FBN-Lidar-Support/Height_Tilt_Measurement/Properties/insert_img.jpg

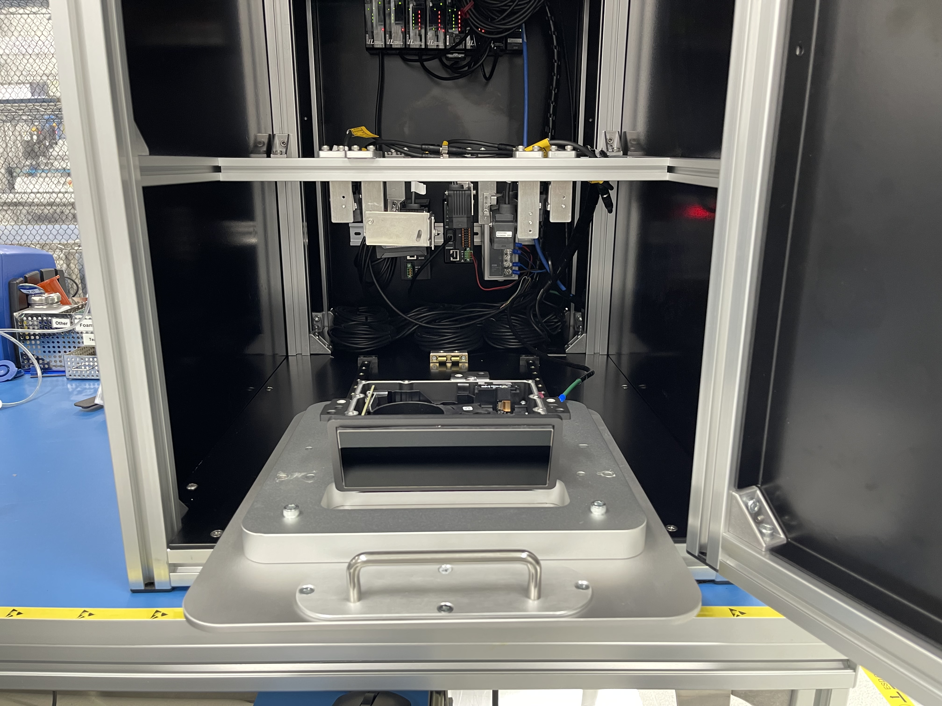
Properties/insert_img.jpg
