FBN-Lidar-Support/Height_Tilt_Measurement/Properties/LR_OB.jpg

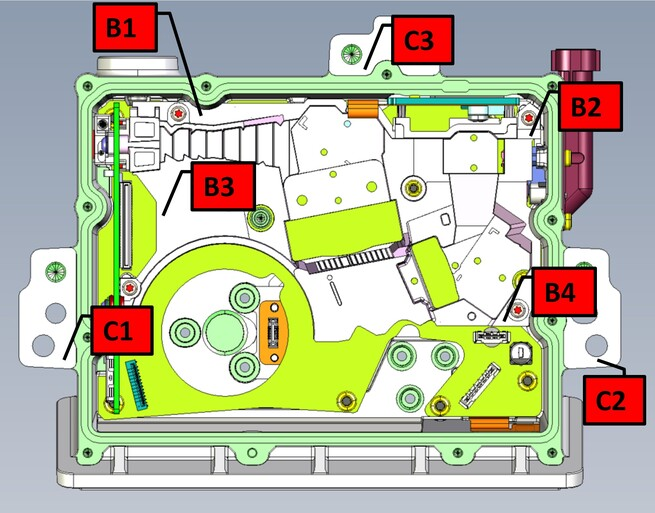
Properties/LR_OB.jpg
