FBN-Lidar-Support/Height_Tilt_Measurement/Properties/SR_OB.jpg

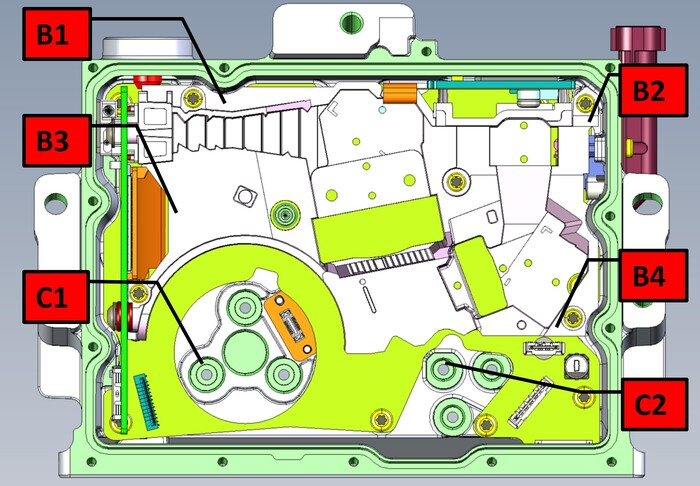
Properties/SR_OB.jpg
