FBN-Lidar-Support/Height_Tilt_Measurement/Doc/ASY00573/ASY00573.STEP

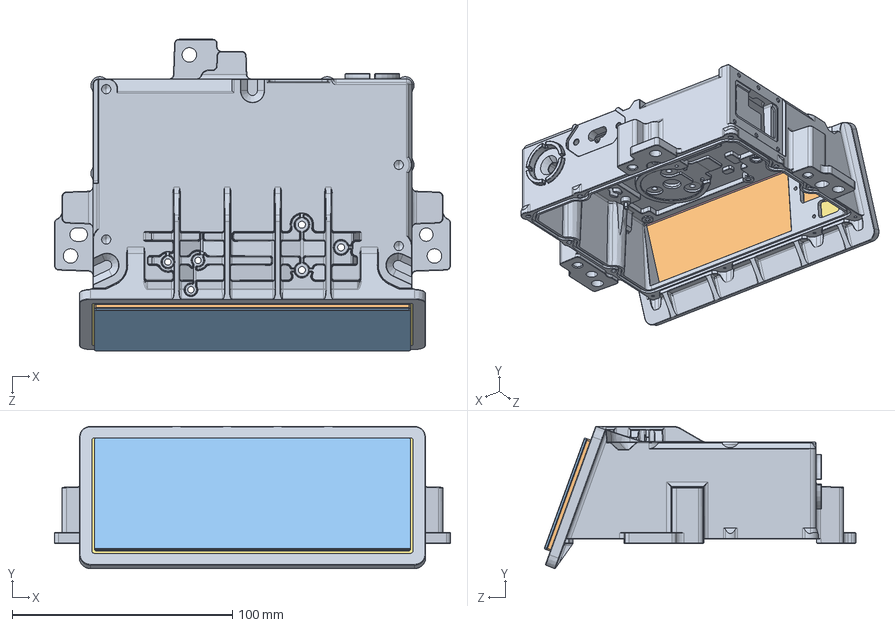
[picture p4: CAD file, 2025-10-30]
Doc/ASY00573/ASY00573.STEP
180.0 x 64.7 x 141.6 mm
MEP02395
Internal Glass Layer^OPT00293_B2.1, Extended Front Window, Saphire & ITO, 20 Deg
External Sapphire Layer^OPT00293_B2.1, Extended Front Window, Saphire & ITO, 20 Deg
PVB^OPT00293_B2.1, Extended Front Window, Saphire & ITO, 20 Deg
Bussbar^OPT00293_B2.1, Extended Front Window, Saphire & ITO, 20 Deg
ITO^OPT00293_B2.1, Extended Front Window, Saphire & ITO, 20 Deg
FPC^PCB00312_B2.1_Win_Heater_Flex
Stiffiner FR4 0.01In^PCB00312_B2.1_Win_Heater_Flex
PSA 3M 9082 2mil^PCB00312_B2.1_Win_Heater_Flex
Stiffener PSA^PCB00312_B2.1_Win_Heater_Flex
Thremistor 0402
Part1^ASY00594
ADH00018^ASY00573
ADH00006^ASY00573
