FBN-Lidar-Support/Height_Tilt_Measurement/Doc/ASY00573/MEP02395.pdf

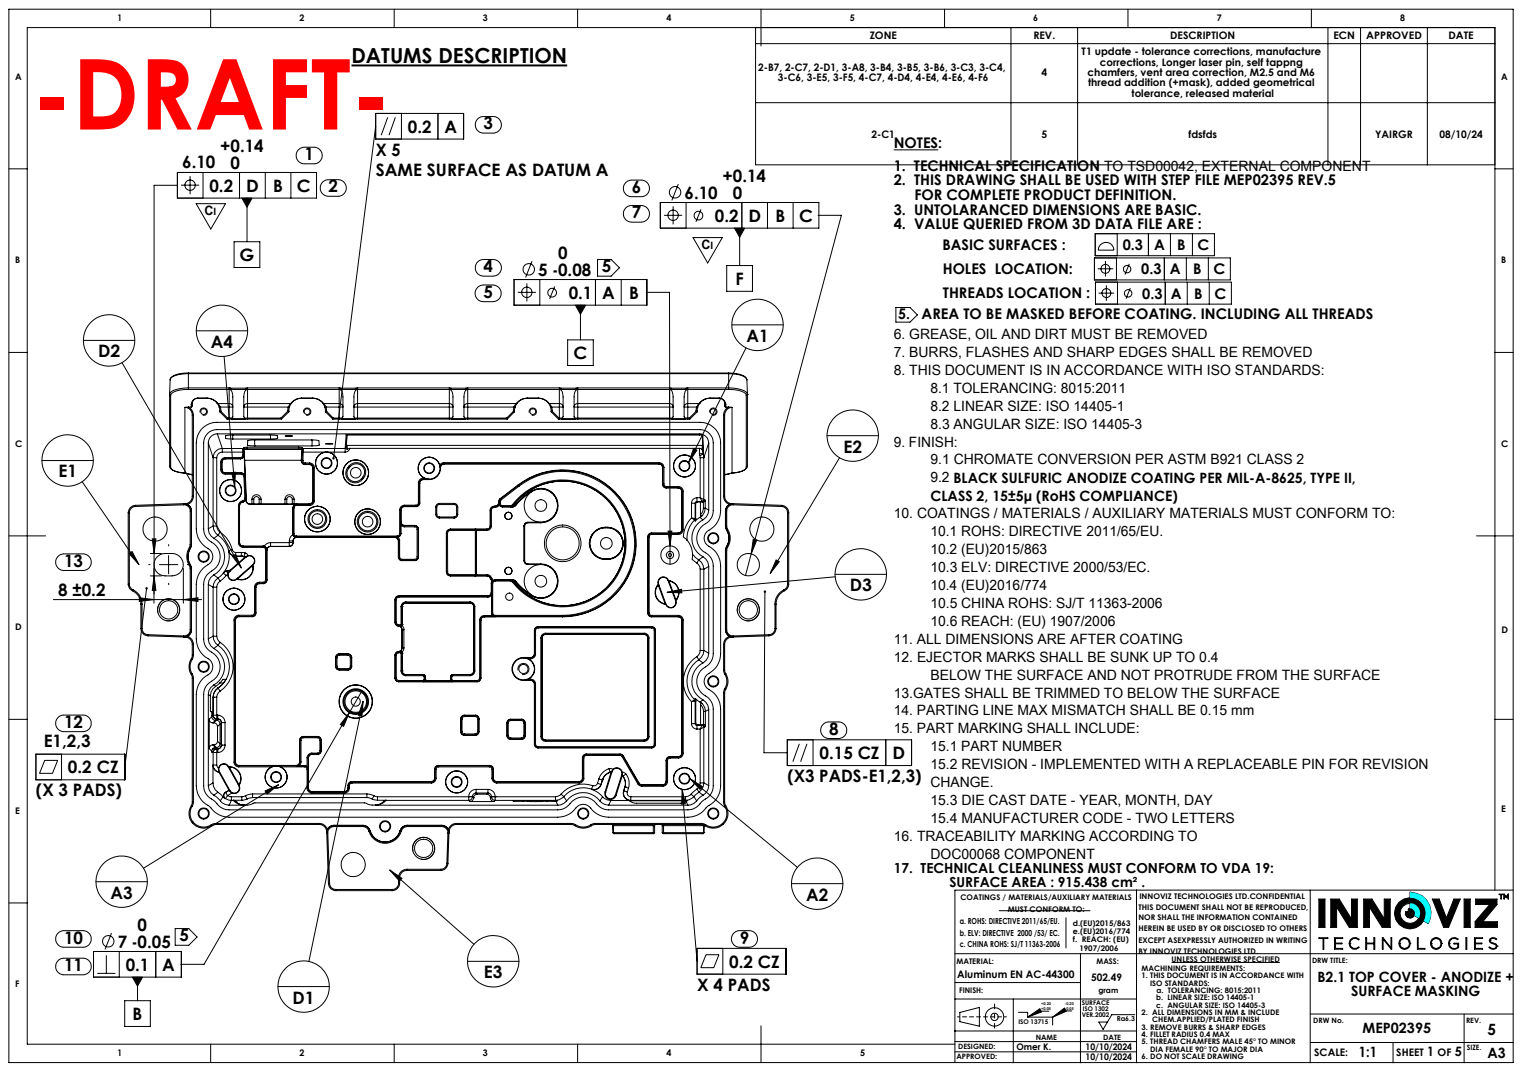
[picture p5: page 1]
ISO 13715; X 5 SAME SURFACE AS DATUM A; 0.2 CZ (X 3 PADS); 0.2 CZ X 4 PADS; DATUMS DESCRIPTION; DRW No.; BASIC SURFACES :; HOLES LOCATION:; THREADS LOCATION :

ZONE | REV. | DESCRIPTION | ECN | APPROVED | DATE

2-B7, 2-C7, 2-D1, 3-A8, 3-B4, 3-B5, 3-B6, 3-C3, 3-C4, 3-C6, 3-E5, 3-F5, 4-C7, 4-D4, 4-E4, 4-E6, 4-F6 | 4 | T1 update - tolerance corrections, manufacture corrections, Longer laser pin, self tappng chamfers, vent area correction, M2.5 and M6 thread addition (+mask), added geometrical tolerance, released material

2-C1 NOTES: | 5 | fdsfds | | YAIRGR | 08/10/24

1. TECHNICAL SPECIFICATION TO TSD00042, EXTERNAL COMPONENT
2. THIS DRAWING SHALL BE USED WITH STEP FILE MEP02395 REV.5
FOR COMPLETE PRODUCT DEFINITION.
3. UNTOLARANCED DIMENSIONS ARE BASIC.
4. VALUE QUERIED FROM 3D DATA FILE ARE :
5. AREA TO BE MASKED BEFORE COATING. INCLUDING ALL THREADS
6. GREASE, OIL AND DIRT MUST BE REMOVED
7. BURRS, FLASHES AND SHARP EDGES SHALL BE REMOVED
8. THIS DOCUMENT IS IN ACCORDANCE WITH ISO STANDARDS:
8.1 TOLERANCING: 8015:2011
8.2 LINEAR SIZE: ISO 14405-1
8.3 ANGULAR SIZE: ISO 14405-3
9. FINISH:

9.1 CHROMATE CONVERSION PER ASTM B921 CLASS 2
9.2 BLACK SULFURIC ANODIZE COATING PER MIL-A-8625, TYPE II,
CLASS 2, 15±5μ (RoHS COMPLIANCE)
10. COATINGS / MATERIALS / AUXILIARY MATERIALS MUST CONFORM TO:
10.1 ROHS: DIRECTIVE 2011/65/EU.
10.3 ELV: DIRECTIVE 2000/53/EC.
10.5 CHINA ROHS: SJ/T 11363-2006
10.6 REACH: (EU) 1907/2006
11. ALL DIMENSIONS ARE AFTER COATING
12. EJECTOR MARKS SHALL BE SUNK UP TO 0.4
BELOW THE SURFACE AND NOT PROTRUDE FROM THE SURFACE
13.GATES SHALL BE TRIMMED TO BELOW THE SURFACE
14. PARTING LINE MAX MISMATCH SHALL BE 0.15 mm
(X3 PADS-E1,2,3)

15. PART MARKING SHALL INCLUDE:
15.1 PART NUMBER
15.2 REVISION - IMPLEMENTED WITH A REPLACEABLE PIN FOR REVISION
CHANGE.
15.3 DIE CAST DATE - YEAR, MONTH, DAY
15.4 MANUFACTURER CODE - TWO LETTERS
16. TRACEABILITY MARKING ACCORDING TO
DOC00068 COMPONENT
17. TECHNICAL CLEANLINESS MUST CONFORM TO VDA 19:
SURFACE AREA : 915.438 cm² .

COATINGS / MATERIALS/AUXILIARY MATERIALS MUST CONFORM TO: a. ROHS: DIRECTIVE 2011/65/EU. d.(EU)2015/863 e.(EU)2016/774 b. ELV: DIRECTIVE 2000 /53/ EC. f. REACH: (EU) c. CHINA ROHS: SJ/T 11363-2006 1907/2006 | INNOVIZ TECHNOLOGIES LTD.CONFIDENTIAL THIS DOCUMENT SHALL NOT BE REPRODUCED, NOR SHALL THE INFORMATION CONTAINED HEREIN BE USED BY OR DISCLOSED TO OTHERS EXCEPT ASEXPRESSLY AUTHORIZED IN WRITING BY INNOVIZ TECHNOLOGIES LTD.

MATERIAL: Aluminum EN AC-44300 FINISH: | MASS: 502.49 gram | UNLESS OTHERWISE SPECIFIED MACHINING REQUIREMENTS: 1. THIS DOCUMENT IS IN ACCORDANCE WITH ISO STANDARDS: a. TOLERANCING: 8015:2011 b. LINEAR SIZE: ISO 14405-1 c. ANGULAR SIZE: ISO 14405-3 2. ALL DIMENSIONS IN MM & INCLUDE CHEM.APPLIED/PLATED FINISH 3. REMOVE BURRS & SHARP EDGES 4. FILLET RADIUS 0.4 MAX 5. THREAD CHAMFERS MALE 45° TO MINOR DIA FEMALE 90° TO MAJOR DIA 6. DO NOT SCALE DRAWING | DRW TITLE: B2.1 TOP COVER - ANODIZE + SURFACE MASKING

+0.20 -0.20 +0.05 -0.05 | SURFACE ISO 1302 VER.2002 Ra6.3

APPROVED: DESIGNED: | | NAME Omer K. | DATE 10/10/2024 10/10/2024
SCALE: 1:1 | SHEET 1 OF 5 | SIZE. A3

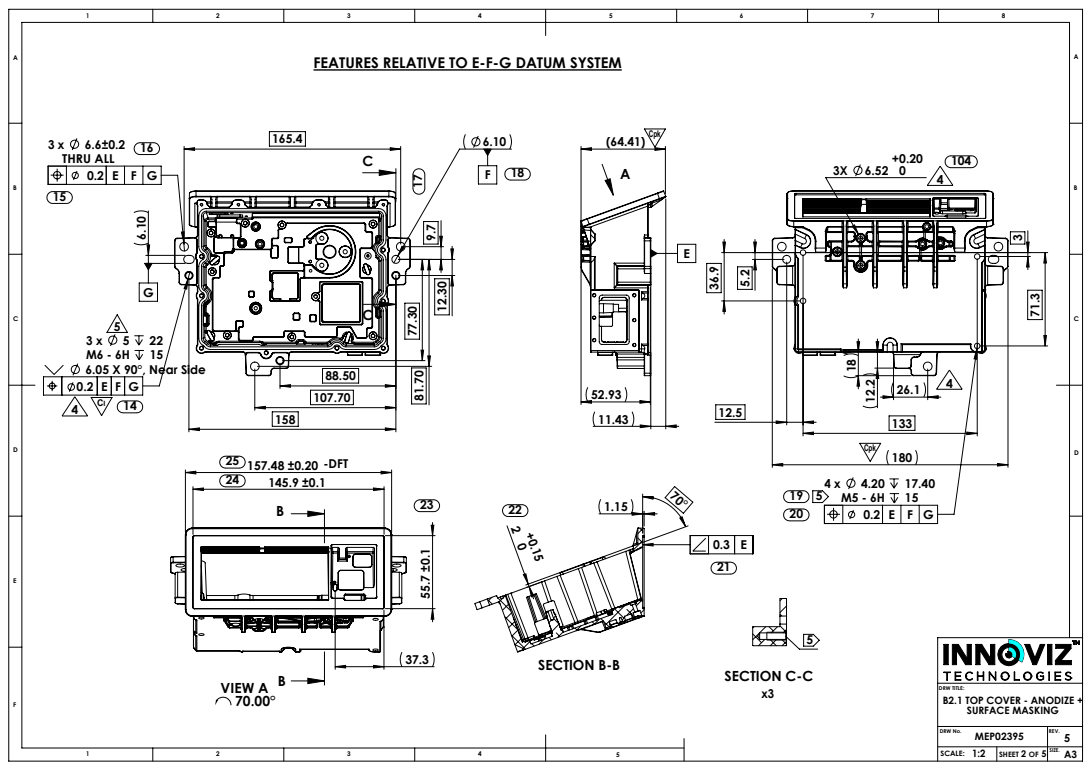
[picture p6: page 2]
3 x 6.6±0.2 THRU ALL; 3 x 5 22 M6 - 6H 15 6.05 X 90°, Near Side; 157.48 ±0.20 -DFT; B VIEW A; SECTION B-B; SECTION C-C

FEATURES RELATIVE TO E-F-G DATUM SYSTEM

DRW TITLE:
B2.1 TOP COVER - ANODIZE +
SURFACE MASKING

MEP02395 | 5
SCALE: 1:2 | SHEET 2 OF 5 | A3

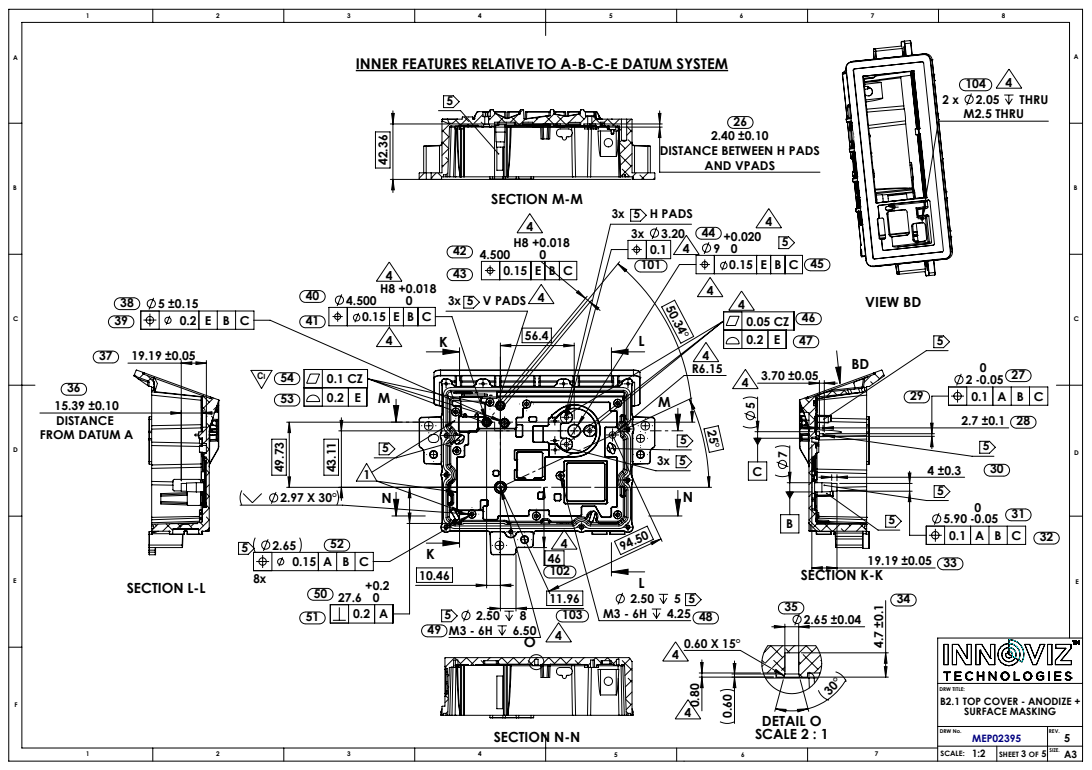
[picture p7: page 3]
3x 5 V PADS; 3x 5 H PADS; SECTION K-K; FROM DATUM A; SECTION L-L; SECTION N-N; DETAIL O SCALE 2 : 1; 2.40 ±0.10 DISTANCE BETWEEN H PADS AND VPADS; SECTION M-M; 5 2 x 2.05 THRU M2.5 THRU; VIEW BD; SCALE:; SHEET 3 OF 5

INNER FEATURES RELATIVE TO A-B-C-E DATUM SYSTEM

DRW TITLE:
B2.1 TOP COVER - ANODIZE +
SURFACE MASKING

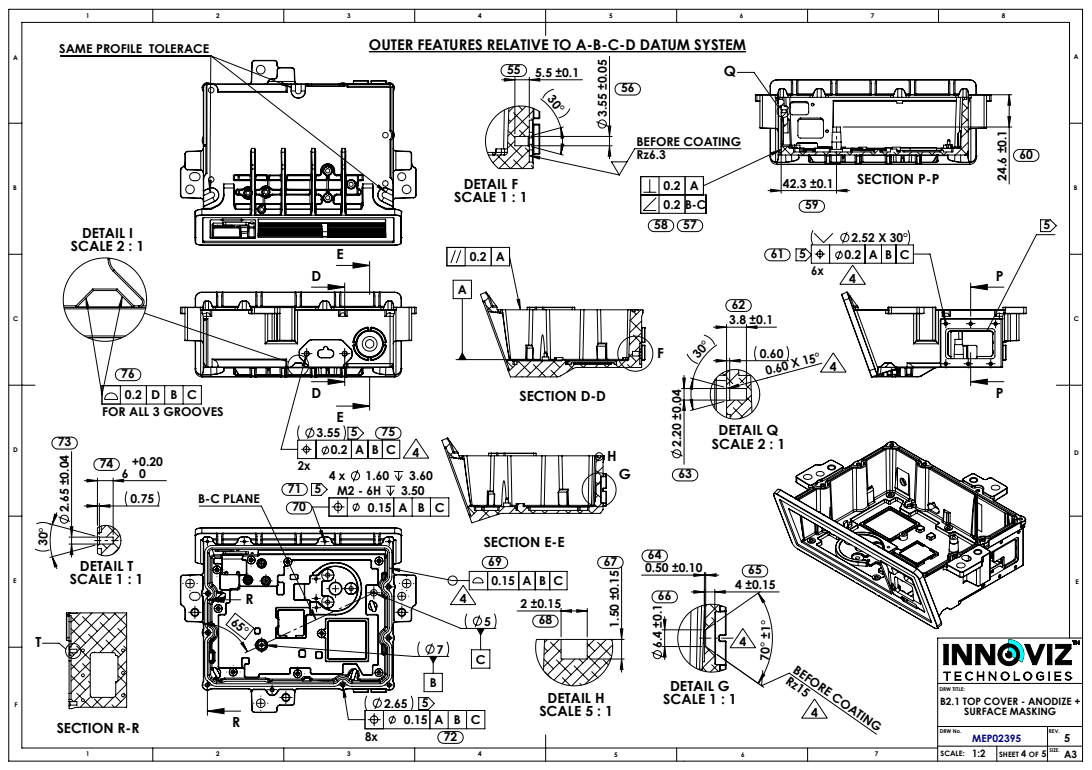
[picture p8: page 4]
B-C PLANE; SECTION D-D; SECTION E-E; DETAIL F SCALE 1 : 1; BEFORE COATING; DETAIL G SCALE 1 : 1; DETAIL H SCALE 5 : 1; DETAIL I SCALE 2 : 1; 0.2 D B C FOR ALL 3 GROOVES; SECTION P-P; DETAIL Q SCALE 2 : 1; SECTION R-R; DETAIL T SCALE 1 : 1; SCALE:; SHEET 4 OF 5

OUTER FEATURES RELATIVE TO A-B-C-D DATUM SYSTEM

SAME PROFILE TOLERACE

DRW TITLE:
B2.1 TOP COVER - ANODIZE +
SURFACE MASKING

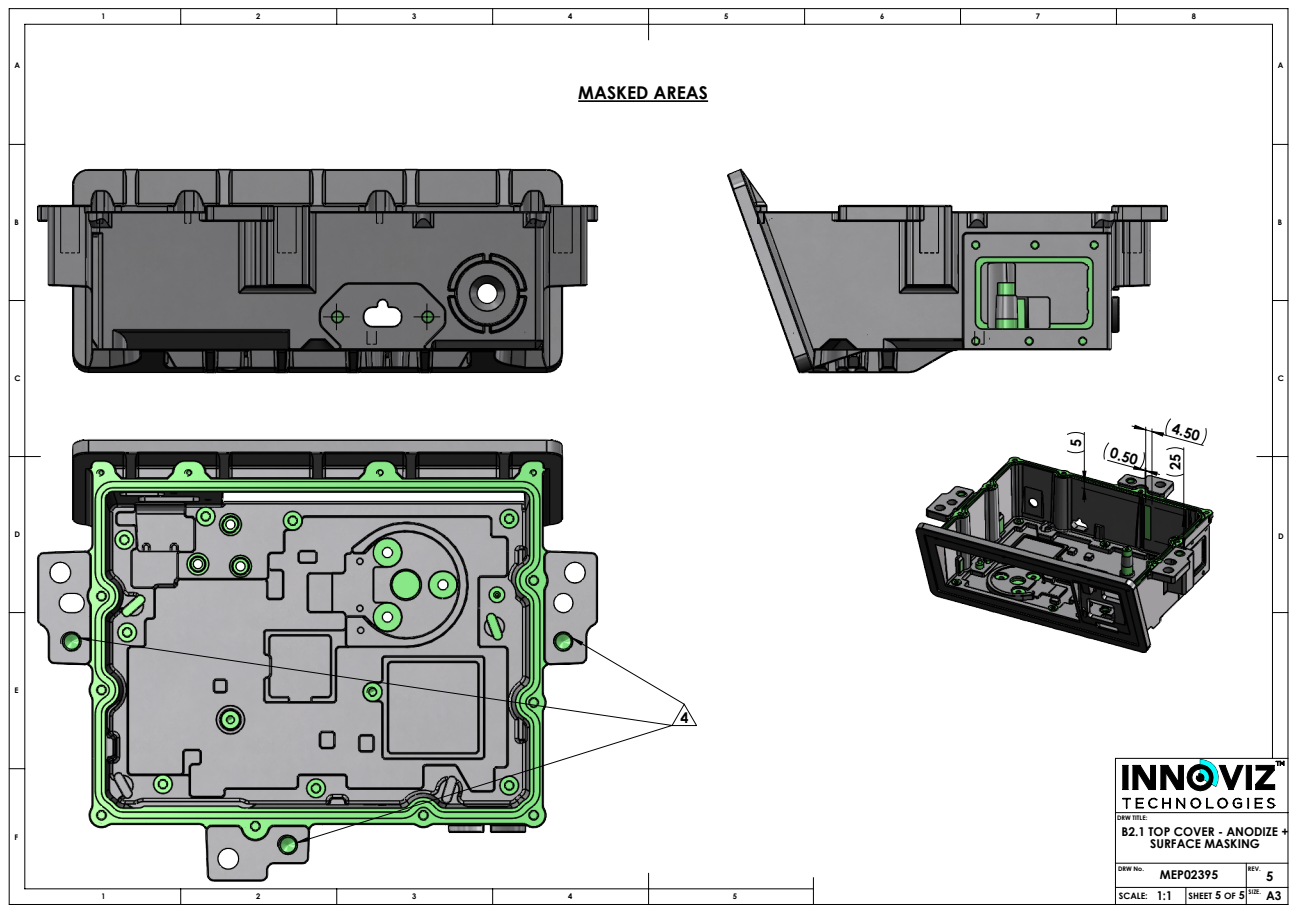
[picture p9: page 5]
MASKED AREAS; SCALE:; SHEET 5 OF 5

DRW TITLE:
B2.1 TOP COVER - ANODIZE +
SURFACE MASKING
