FBN-Lidar-Support/Height_Tilt_Measurement/Doc/ASY00573/ASY00573.pdf

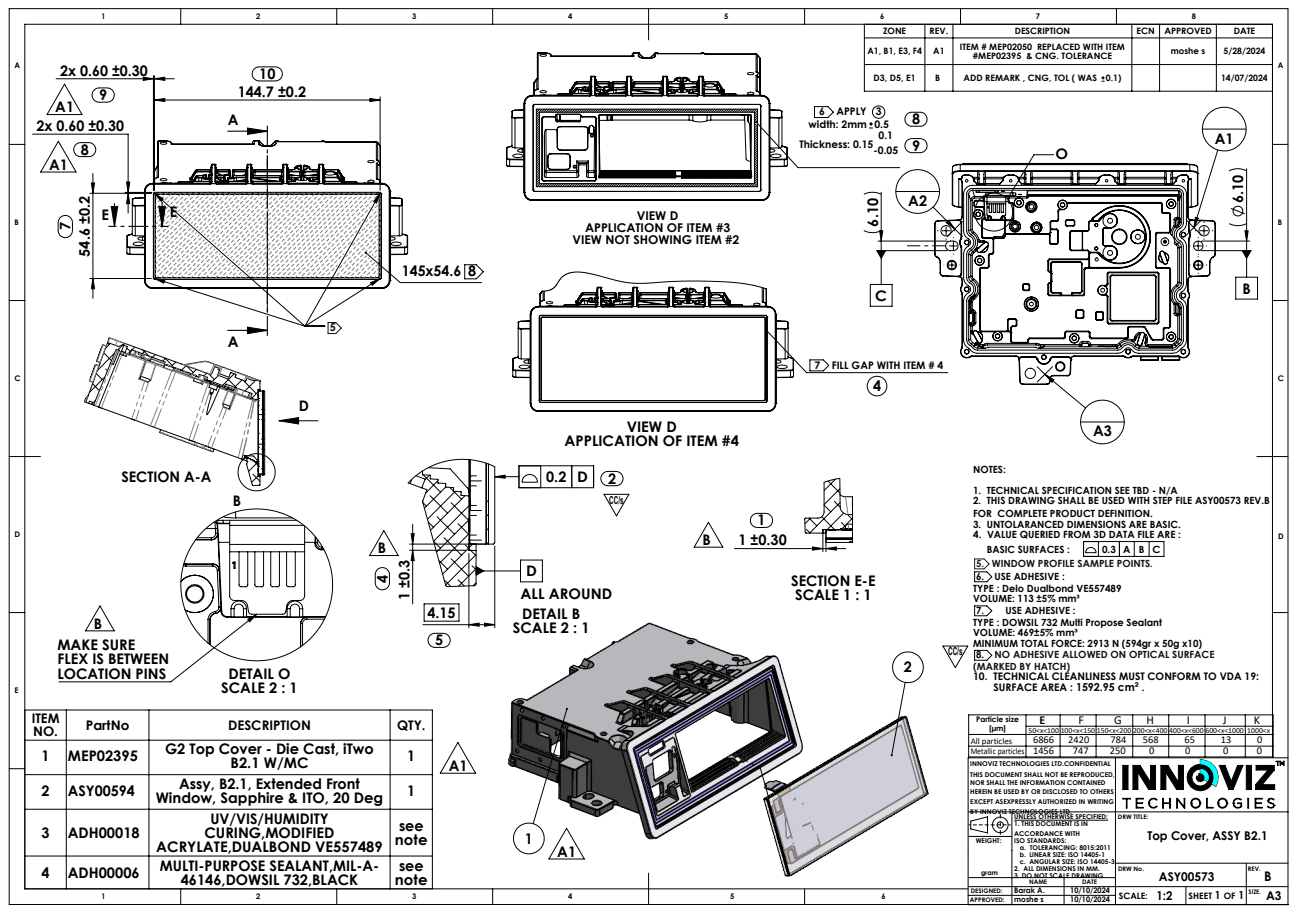
[picture p10: page 1]
SECTION A-A; VIEW D; 6 APPLY 3 width: 2mm 0.5 Thickness: 0.15; SECTION E-E SCALE 1 : 1; VIEW D APPLICATION OF ITEM #4; DETAIL B SCALE 2 : 1; ALL AROUND; DETAIL O SCALE 2 : 1; BASIC SURFACES :; APPROVED:; A3 DESIGNED:; DRW No.; SCALE:; SHEET 1 OF 1 10/10/2024; Barak A.; moshe s

ZONE | REV. | DESCRIPTION | ECN | APPROVED | DATE
A1, B1, E3, F4 | A1 | ITEM # MEP02050 REPLACED WITH ITEM #MEP02395 & CNG. TOLERANCE | | moshe s | 5/28/2024

D3, D5, E1 | B | ADD REMARK , CNG, TOL ( WAS 0.1) | | | 14/07/2024

APPLICATION OF ITEM #3
VIEW NOT SHOWING ITEM #2

7 FILL GAP WITH ITEM # 4

NOTES:
1. TECHNICAL SPECIFICATION SEE TBD - N/A
2. THIS DRAWING SHALL BE USED WITH STEP FILE ASY00573 REV.B
FOR COMPLETE PRODUCT DEFINITION.
3. UNTOLARANCED DIMENSIONS ARE BASIC.
4. VALUE QUERIED FROM 3D DATA FILE ARE :
5. WINDOW PROFILE SAMPLE POINTS.
6. USE ADHESIVE :
TYPE : Delo Dualbond VE557489
VOLUME: 113 ±5% mm³
7. USE ADHESIVE :
TYPE : DOWSIL 732 Multi Propose Sealant
VOLUME: 469±5% mm³
MINIMUM TOTAL FORCE: 2913 N (594gr x 50g x10)
8. NO ADHESIVE ALLOWED ON OPTICAL SURFACE
(MARKED BY HATCH)
10. TECHNICAL CLEANLINESS MUST CONFORM TO VDA 19:
SURFACE AREA : 1592.95 cm² .

MAKE SURE
FLEX IS BETWEEN
LOCATION PINS

ITEM NO. | PartNo | DESCRIPTION | QTY.
1 | MEP02395 | G2 Top Cover - Die Cast, iTwo B2.1 W/MC | 1
2 | ASY00594 | Assy, B2.1, Extended Front Window, Sapphire & ITO, 20 Deg | 1
3 ADH00018 | | UV/VIS/HUMIDITY CURING,MODIFIED ACRYLATE,DUALBOND VE557489 | see note

Particle size [µm] | E | F | G | H | I | J | K
All particles | 6866 | 2420 | 784 | 568 | 65 | 13 | 0
Metallic particles | 1456 | 747 | 250 | 0 | 0 | 0 | 0
INNOVIZ TECHNOLOGIES LTD.CONFIDENTIAL THIS DOCUMENT SHALL NOT BE REPRODUCED, NOR SHALL THE INFORMATION CONTAINED HEREIN BE USED BY OR DISCLOSED TO OTHERS EXCEPT ASEXPRESSLY AUTHORIZED IN WRITING BY INNOVIZ TECHNOLOGIES LTD.

UNLESS OTHERWISE SPECIFIED: 1. THIS DOCUMENT IS IN ACCORDANCE WITH ISO STANDARDS: a. TOLERANCING: 8015:2011 b. LINEAR SIZE: ISO 14405-1 c. ANGULAR SIZE: ISO 14405-3 2. ALL DIMENSIONS IN MM. 3. DO NOT SCALE DRAWING | DRW TITLE: Top Cover, ASSY B2.1

4 | ADH00006 | MULTI-PURPOSE SEALANT,MIL-A-46146,DOWSIL 732,BLACK | see note
