FBN-Lidar-Support/Height_Tilt_Measurement/Doc/ASY00573/ASY00594.pdf

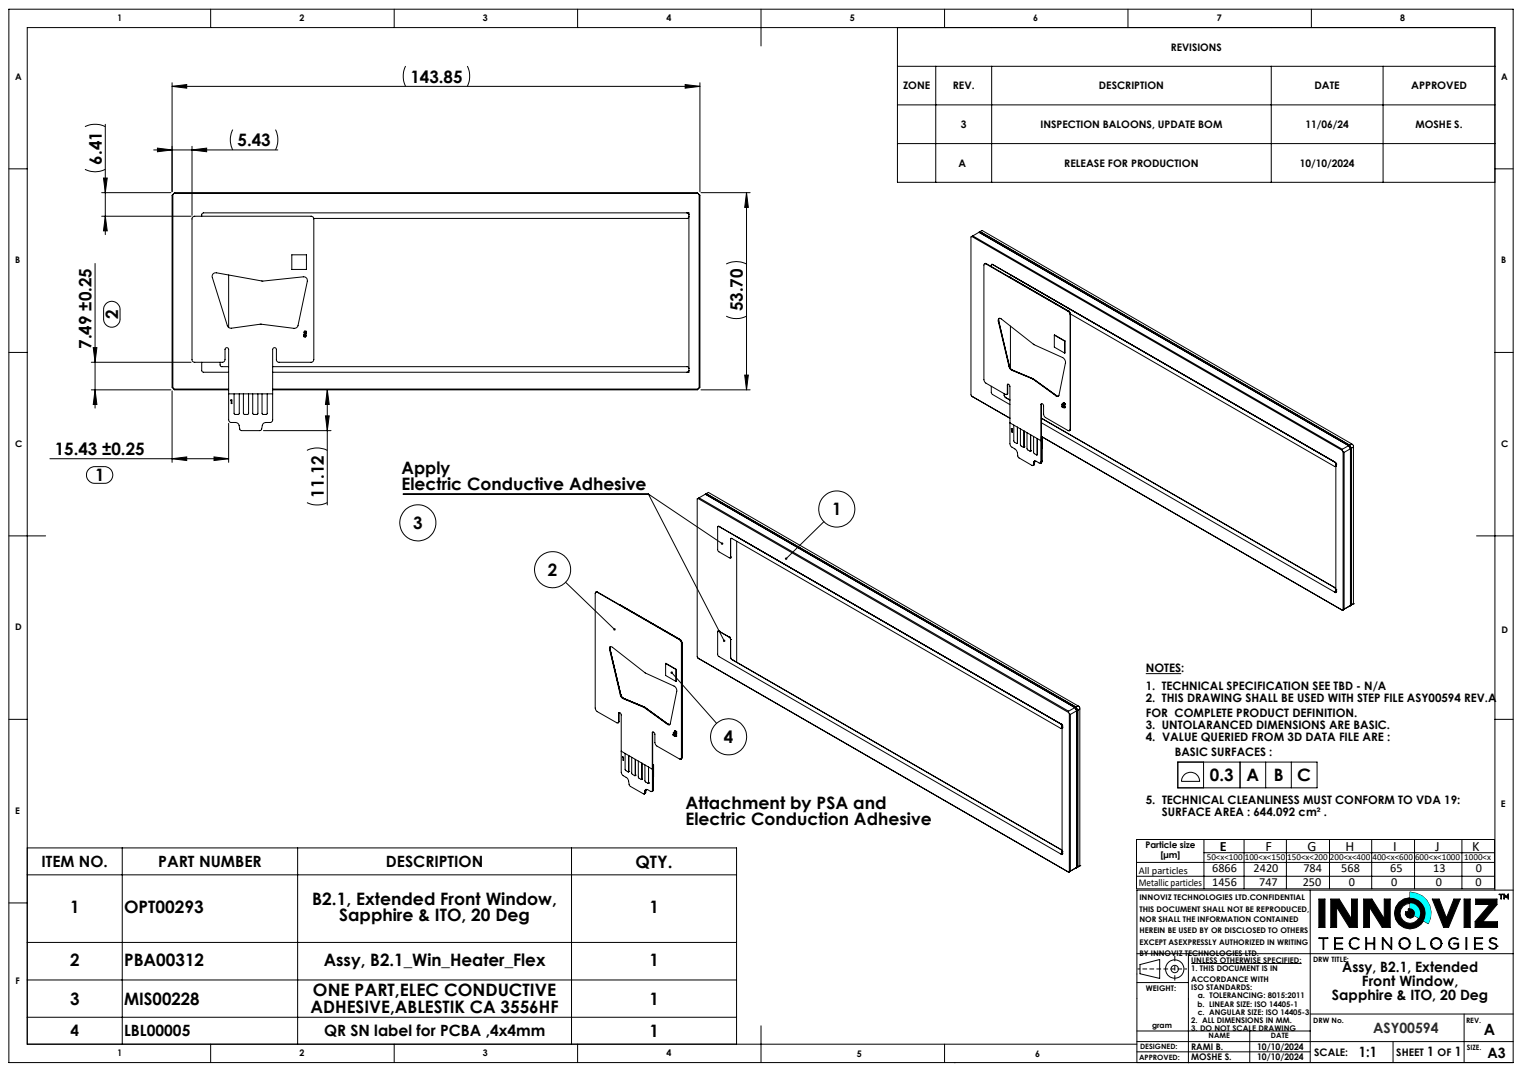
[picture p11: page 1]
Metallic particles; Electric Conductive Adhesive; OPT00293; B2.1, Extended Front Window,; Sapphire & ITO, 20 Deg; PBA00312; Assy, B2.1_Win_Heater_Flex; MIS00228; ONE PART,ELEC CONDUCTIVE; ADHESIVE,ABLESTIK CA 3556HF; APPROVED:; A3 DESIGNED:; DRW No.; SCALE:; SHEET 1 OF 1 10/10/2024; RAMI B.; MOSHE S.

ZONE | REV. | DESCRIPTION | DATE | APPROVED

3 | INSPECTION BALOONS, UPDATE BOM | 11/06/24 | MOSHE S.

A | RELEASE FOR PRODUCTION | 10/10/2024

NOTES:
1. TECHNICAL SPECIFICATION SEE TBD - N/A
2. THIS DRAWING SHALL BE USED WITH STEP FILE ASY00594 REV.A
FOR COMPLETE PRODUCT DEFINITION.
3. UNTOLARANCED DIMENSIONS ARE BASIC.
4. VALUE QUERIED FROM 3D DATA FILE ARE :
BASIC SURFACES :

Attachment by PSA and
Electric Conduction Adhesive

5. TECHNICAL CLEANLINESS MUST CONFORM TO VDA 19:
SURFACE AREA : 644.092 cm² .

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

ITEM NO. | PART NUMBER | DESCRIPTION | QTY.

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

UNLESS OTHERWISE SPECIFIED: 1. THIS DOCUMENT IS IN ACCORDANCE WITH ISO STANDARDS: a. TOLERANCING: 8015:2011 b. LINEAR SIZE: ISO 14405-1 c. ANGULAR SIZE: ISO 14405-3 2. ALL DIMENSIONS IN MM. 3. DO NOT SCALE DRAWING | DRW TITLE: Assy, B2.1, Extended Front Window, Sapphire & ITO, 20 Deg

4 | LBL00005 | QR SN label for PCBA ,4x4mm | 1
