FBN-Lidar-Support/Height_Tilt_Measurement/Doc/ASY00573/OPT00293_B2.1, Extended Front Window, Saphire & ITO, 20 Deg.pdf

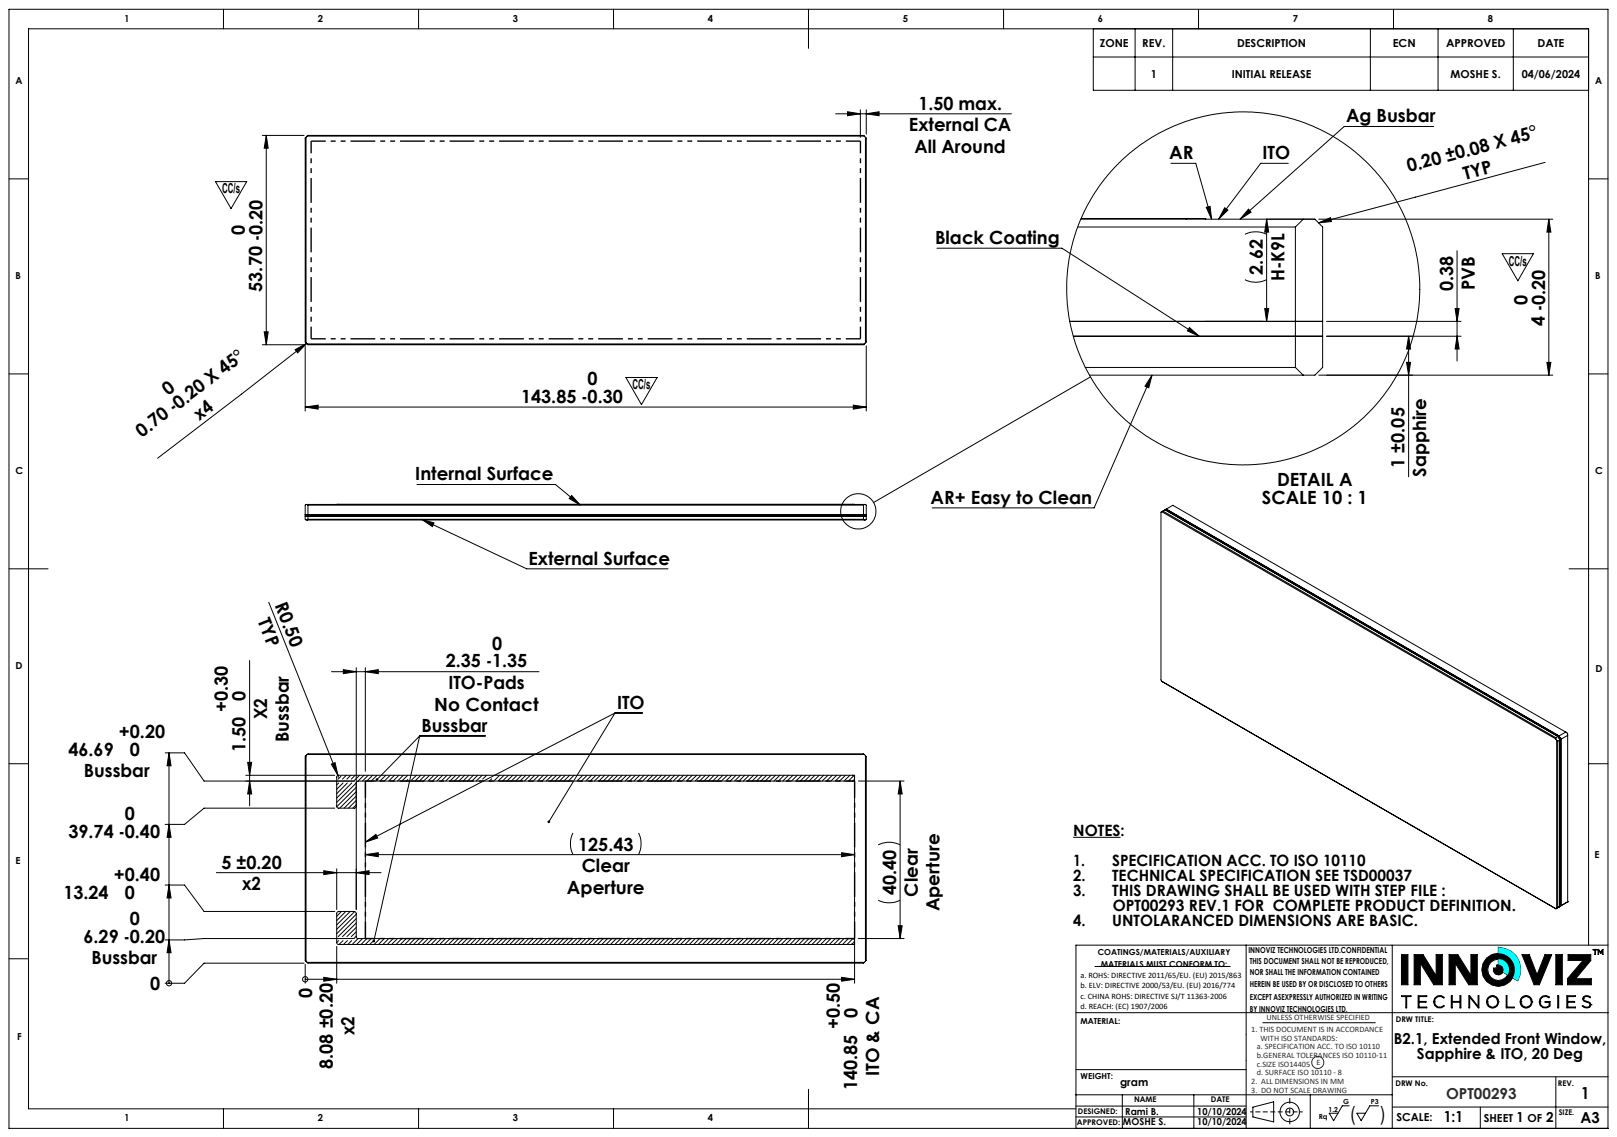
[picture p12: page 1]
1.50 max. External CA All Around; External Surface; Internal Surface; No Contact; ITO & CA; DETAIL A SCALE 10 : 1; Ag Busbar; Black Coating; APPROVED:; A3 DESIGNED:; DRW No.; SCALE:; SHEET 1 OF 2; Rami B.; MOSHE S.

ZONE | REV. | DESCRIPTION | ECN | APPROVED | DATE

1 | INITIAL RELEASE | | MOSHE S. | 04/06/2024

AR+ Easy to Clean

NOTES:
1. SPECIFICATION ACC. TO ISO 10110
2. TECHNICAL SPECIFICATION SEE TSD00037
3. THIS DRAWING SHALL BE USED WITH STEP FILE :
OPT00293 REV.1 FOR COMPLETE PRODUCT DEFINITION.
4. UNTOLARANCED DIMENSIONS ARE BASIC.

COATINGS/MATERIALS/AUXILIARY MATERIALS MUST CONFORM TO: a. ROHS: DIRECTIVE 2011/65/EU. (EU) 2015/863 b. ELV: DIRECTIVE 2000/53/EU. (EU) 2016/774 c. CHINA ROHS: DIRECTIVE SJ/T 11363-2006 d. REACH: (EC) 1907/2006 | INNOVIZ TECHNOLOGIES LTD.CONFIDENTIAL THIS DOCUMENT SHALL NOT BE REPRODUCED, NOR SHALL THE INFORMATION CONTAINED HEREIN BE USED BY OR DISCLOSED TO OTHERS EXCEPT ASEXPRESSLY AUTHORIZED IN WRITING BY INNOVIZ TECHNOLOGIES LTD.

MATERIAL: WEIGHT: gram | UNLESS OTHERWISE SPECIFIED 1. THIS DOCUMENT IS IN ACCORDANCE WITH ISO STANDARDS: a. SPECIFICATION ACC. TO ISO 10110 b.GENERAL TOLERANCES ISO 10110-11 c.SIZE ISO14405 E d. SURFACE ISO 10110 - 8 2. ALL DIMENSIONS IN MM 3. DO NOT SCALE DRAWING | DRW TITLE: B2.1, Extended Front Window, Sapphire & ITO, 20 Deg

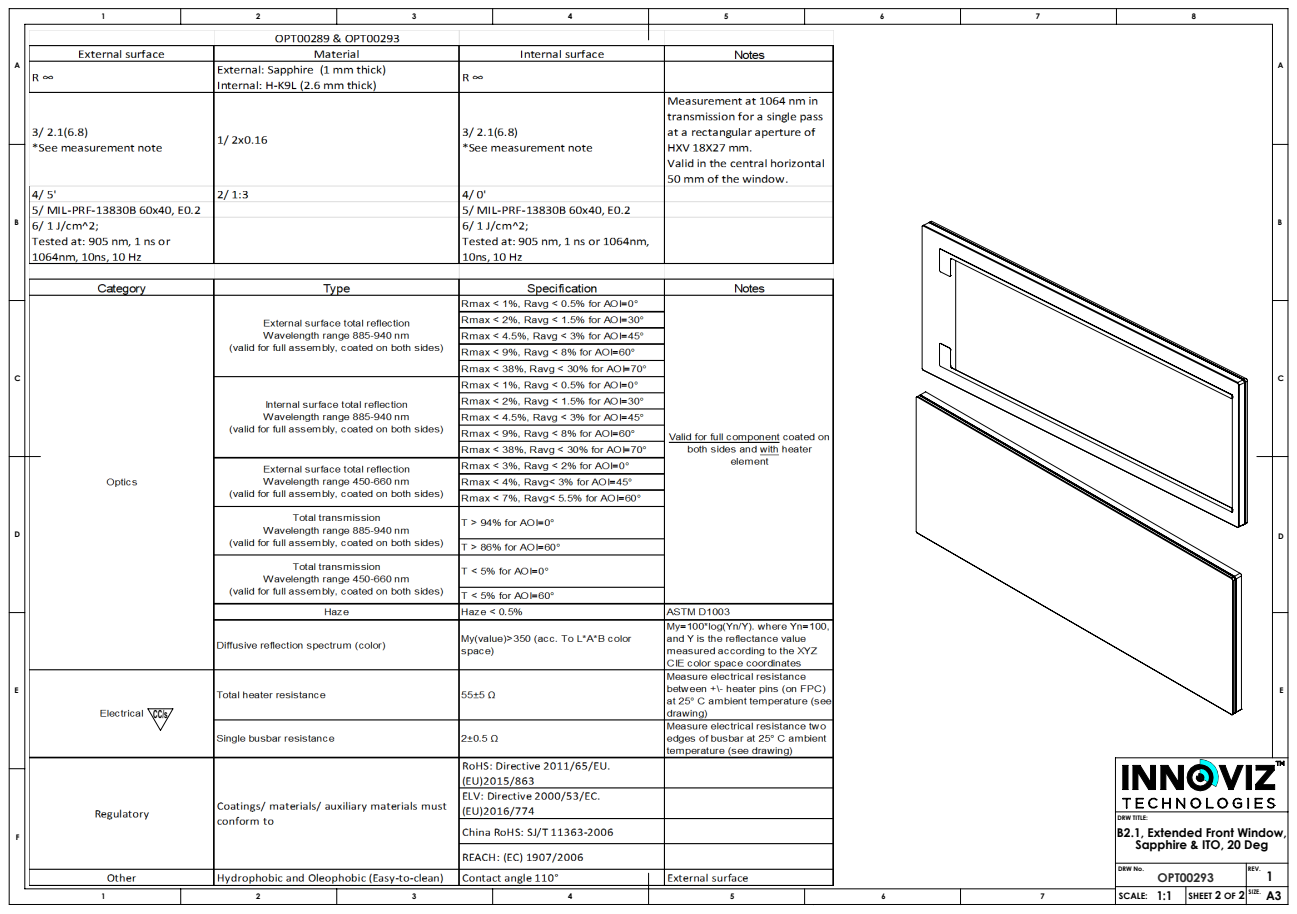
[picture p13: page 2]
DRW No.; SCALE:; SHEET 2 OF 2

DRW TITLE:
B2.1, Extended Front Window,
Sapphire & ITO, 20 Deg
