FBN-Lidar-Support/Height_Tilt_Measurement/Properties/Config.ini

[DEFAULT]
logpath = D:\Displacement\Log
ip_1 = 169.254.148.227
port_1 = 64000
ip_2 = 169.254.148.228
port_2 = 64000
retry = True

[SENSOR_POSITION]
sensor_1 = 0.00,0.00
sensor_2 = 161.00,17.00
sensor_3 = 89.70,86.00
sensor_4 = 40.30,78.40
sensor_5 = 139.98,64.86
sensor_6 = 28.80,48.30
sensor_7 = 137.00,8.00
sensor_8 = 57.05,-5.36
sensor_9 = 100.07,0.240

[LR]
list_sensors = 1,2,3,4,5,6,7
referance_sensors = 1,2,3
measure_sensors = 4,5,6,7
test_ob_hight = True
test_ob_tilt = True
test_ob_relative = True

[SR]
list_sensors = 4,5,6,7,8,9
referance_sensors = 8,9
measure_sensors = 4,5,6,7
test_ob_hight = True
test_ob_tilt = True
test_ob_relative = True

[Test_OB_Hight]
lr_nominal = -18.11
lr_tolerance = 0.35
sr_nominal = 25.65
sr_tolerance = 0.35

[Test_OB_Relative]
lr_tolerance = 0.3
sr_tolerance = 0.3

[CALIBRATED_JIG]
nominal_s1 = 0.000
nominal_s2 = 0.000
nominal_s3 = 0.000
nominal_s4 = -18.110
nominal_s5 = -18.110
nominal_s6 = -18.110
nominal_s7 = -18.110
nominal_s8 = -43.760
nominal_s9 = -42.750
dn_s1 = 0.000
dn_s2 = 0.000
dn_s3 = 0.000
dn_s4 = 0.000
dn_s5 = 0.000
dn_s6 = 0.000
dn_s7 = 0.000
dn_s8 = 0.000
dn_s9 = 0.000

[FITs]
model = Main line
operationlist = IN375
sr = INNS00B0,INNS00B1,ISSC1B1E,ISSC1B2E
lr = INNC2102,INNC2104,ILCC1B1G,ILCC1B2G
raven = ILRC1A1E
issc1b1e = {"CIN000037503":"FAIL","CIN000037504":"PASS"}
issc1b2e = {"CIN000037503":"FAIL","CIN000037504":"PASS"}
ilcc1b1g = {"CIN000037501":"PASS","CIN000037502":"FAIL"}
ilcc1b2g = {"CIN000037501":"PASS","CIN000037502":"FAIL"}

[GOLDEN-UNIT]
cin000037501 = ILCC1B2G,ILRC1A1E
cin000037502 = ILCC1B1G,ILRC1A1E
cin000037503 = ISSC1B1E
cin000037504 = ISSC1B2E
