FBN-Lidar-Support/Height_Tilt_Measurement/(commit log)

2025-08-19 debug reset values after finish_cycle
    [Config.ini]
2025-08-19 Add Master Doc
    [OB INSPECTION NO3_2.csv, OB INSPECTION NO9_2.csv, OB inspection.xlsx]
2025-10-23 Add webservice.py Update GUI - show diff of each bench offset - reset offset sensor button
2025-10-30 add SR_OB.jpg
    [ASY00573.STEP]
2026-06-25 Initial commit Add 2 sensor for measure SR Model
2026-07-01 Add sensor_repeat_check.py
2026-07-01 update sensor_repeat_check.py to read all sensor
2026-07-09 Software V0.65 Add function validate sensor offset
2026-08-17 update monthly Calibration
2026-09-07 Added calibration_record.py
